twospoons/jayday_fez40/bom_parts.txt

http://www.dipmicro.com/store/index.php?act=viewProd&productCode=CON-MICROSD1
($0.25 per piece)
