twospoons/jayday_fez40/bom.xlsx

Sheet: Sheet1
QTY TOTAL | 100
ADD PERCENT | 1.1 | (10% extra)
QTY | Total Order | Part NO | Price 1 | URL | Value | Device | Package | Description
3 | 330 | 475-1410-1-ND | 0.051 | http://www.digikey.com/product-detail/en/LG%20R971-KN-1-0-20-R18/475-1410-2-ND/1227925 |  | LEDCHIPLED_0805 | CHIPLED_0805 | LED
5 | 550 | 399-1095-1-ND | 0.00808 | http://www.digikey.com/product-detail/en/C0603C104K8RACTU/399-1095-1-ND/411370 | .1uF | C-USC0603K | C0603K | CAPACITOR, American symbol
2 | 220 | 445-1274-1-ND | 0.013 | http://www.digikey.com/product-detail/en/C1608C0G1H270J/445-1274-2-ND/513761 | 27pF | C-USC0603K | C0603K | CAPACITOR, American symbol
2 | 220 | 493-2331-1-ND | 0.22 | http://www.digikey.com/product-detail/en/F921A225MPA/493-2331-1-ND/677799 | 2.2uF | C-USC0805K | C0805K | CAPACITOR, American symbol
1 | 110 | 478-3875-1-ND | 0.32 | http://www.digikey.com/product-detail/en/TAJB106M010RNJ/478-3875-1-ND/1126921 | 10uF | CPOL-USCT3528 | CT3528 | POLARIZED CAPACITOR, American symbol
1 | 110 | 493-4092-1-ND | 0.3 | http://www.digikey.com/product-detail/en/F920J226MPA/493-4092-1-ND/2529819 | 22uF | C-USC0805K | C0805K | CAPACITOR, American symbol
1 | 110 | 399-4781-1-ND | 2.6 | http://www.digikey.com/product-detail/en/T495X227K010ATE060/399-4781-1-ND/1001269 | 220uF 10V B45197A1227K409 | CPOL-USD/7343-31W | D/7343-31W | POLARIZED CAPACITOR, American symbol
1 | 110 | 478-1780-1-ND | 1.71 | http://www.digikey.com/product-detail/en/TPSD156K035R0300/478-1780-1-ND/564812 | 15uF 35V T491D156K035AT | CPOL-USD/7343-31W | D/7343-31W | POLARIZED CAPACITOR, American symbol
1 | 110 | 455-1719-ND | 0.094 | http://www.digikey.com/product-detail/en/S2B-PH-K-S(LF)(SN)/455-1719-ND/926626 |  | JST_2PIN-THM-RA | JST-PH-2-THM-RA | JST 2-Pin Connectors of various flavors
1 | 110 | PRT-09914 | 0.76 | https://www.sparkfun.com/products/9914 | JST FEMALE WITH WIRES
1 | 110 | B260A-FDICT-ND | 0.25 | http://www.digikey.com/product-detail/en/B260A-13-F/B260A-FDICT-ND/755494 | B260 | DIODE_SMA | DIODE_SMA
1 | 110 | 497-11767-ND | 8.84 | http://www.digikey.com/product-detail/en/STM32F405RGT6/497-11767-ND/2754208 | GHI_STM32F40X | GHI_STM32F40X | GHI_LQFP64
1 | 110 | LM1117IMPX-3.3/NOPBCT-ND | 0.768 | http://www.digikey.com/product-detail/en/LM1117IMPX-3.3%2FNOPB/LM1117IMPX-3.3%2FNOPBCT-ND/3440160 | LM1117MP-3.3 | LM1117 | SOT223
1 | 110 | 576-1221-1-ND | 1.97 | http://www.digikey.com/product-detail/en/MIC4680-5.0YM%20TR/576-1221-1-ND/771873 | MIC4680-ADJ | MIC4680 | SO8
1 | 110 | 513-1083-1-ND | 1.22 | http://www.digikey.com/product-detail/en/UP2B-680-R/513-1083-1-ND/695364 | 68uH | UP2BXXX | UP2BXXX
1 | 110 |  | 0.5 |  | SHF105 | SHF105 | GAD_PAC_SMD
2 | 220 |  | 0.1 |  |  | M02PTH | 1X02 | Header 2
3 | 330 | SI2312BDS-T1-GE3CT-ND | 0.28 | http://www.digikey.com/product-detail/en/SI2312BDS-T1-GE3/SI2312BDS-T1-GE3CT-ND/1995606 | SI2312BDS | SI2312BDS | TO-236
1 | 110 | 311-825HRCT-ND | 0.006 | http://www.digikey.com/product-detail/en/RC0603FR-07825RL/311-825HRCT-ND/730352 | 825ohm | R0603
1 | 110 | 887-1268-1-ND | 0.405 | http://www.digikey.com/product-detail/en/9C-12.000MEEJ-T/887-1268-1-ND/2207850 | 12Mhz | CRYTALSM49 | SM49@1 | CRYSTAL
5 | 550 | RNCP0603FTD10K0CT-ND | 0.0086 | http://www.digikey.com/product-detail/en/RNCP0603FTD10K0/RNCP0603FTD10K0CT-ND/2240478 | 10K | R-US_R0603 | R0603 | RESISTOR, American symbol
2 | 220 | 311-22GRCT-ND | 0.004 | http://www.digikey.com/product-detail/en/RC0603JR-0722RL/311-22GRCT-ND/729690 | 22 | R-US_R0603 | R0603 | RESISTOR, American symbol
2 | 220 | 311-330GRCT-ND | 0.0048 | http://www.digikey.com/product-detail/en/RC0603JR-07330RL/311-330GRCT-ND/729716 | 330 | R-US_R0603 | R0603 | RESISTOR, American symbol
3 | 330 | A106046CT-ND | 0.00316 | http://www.digikey.com/product-detail/en/1622827-1/A106046CT-ND/3477684 | 100K | R-US_R0603 | R0603 | RESISTOR, American symbol
1 | 110 | 609-1046-ND | 0.41 | http://www.digikey.com/product-detail/en/54602-908LF/609-1046-ND/1001360 | RJ45-8PTH | RJ45-8PTH | RJ45-8 | RJ45 Jack
1 | 110 |  | 0.24 | http://www.dipmicro.com/store/index.php?act=viewProd&productCode=CON-MICROSD1 | MICROSD_MICROSD | MICROSD_MICROSD | MICROSD_MICROSD
1 | 110 | 649-10033526-N3212LF | 0.4 | http://www.mouser.com/ProductDetail/FCI/10033526-N3212LF/ | DX2R005HN2E700 | USB-MB-S | USB-MB-S | USB Connectors
1 | 110 | PCB | 1
Price per |  |  | 22.48564
Modem |  |  | 29
Stencil |  |  | 45
Price for 100 |  |  | 5708.4204

Sheet: Sheet2
Part | Part NO | Price (when ordering 100x) | URL | Value | Device | Package | Description
+5V | 475-1410-1-ND | 0.059 | http://www.digikey.com/product-detail/en/LG%20R971-KN-1-0-20-R18/475-1410-2-ND/1227925 |  | LEDCHIPLED_0805 | CHIPLED_0805 | LED
+12V | 475-1410-1-ND | 0.059 | http://www.digikey.com/product-detail/en/LG%20R971-KN-1-0-20-R18/475-1410-2-ND/1227925 |  | LEDCHIPLED_0805 | CHIPLED_0805 | LED
C1 |  |  |  | .1uF | C-USC0603K | C0603K | CAPACITOR, American symbol
C2 |  |  |  | .1uF | C-USC0603K | C0603K | CAPACITOR, American symbol
C3 |  |  |  | .1uF | C-USC0603K | C0603K | CAPACITOR, American symbol
C4 |  |  |  | .1uF | C-USC0603K | C0603K | CAPACITOR, American symbol
C6 |  |  |  | 27pF | C-USC0603K | C0603K | CAPACITOR, American symbol
C7 |  |  |  | 27pF | C-USC0603K | C0603K | CAPACITOR, American symbol
C8 |  |  |  | 2.2uF | C-USC0805K | C0805K | CAPACITOR, American symbol
C9 |  |  |  | 2.2uF | C-USC0805K | C0805K | CAPACITOR, American symbol
C10 |  |  |  | 10uF | CPOL-USCT3528 | CT3528 | POLARIZED CAPACITOR, American symbol
C12 |  |  |  | .1uF | C-USC0603K | C0603K | CAPACITOR, American symbol
C13 |  |  |  | 22uF | C-USC0805K | C0805K | CAPACITOR, American symbol
C29 |  |  |  | 220uF 6.3V B45197A1227K409 | CPOL-USD/7343-31W | D/7343-31W | POLARIZED CAPACITOR, American symbol
C37 |  |  |  | 15uF 35V T491D156K035AT | CPOL-USD/7343-31W | D/7343-31W | POLARIZED CAPACITOR, American symbol
CN1 |  |  |  |  | JST_2PIN-THM-RA | JST-PH-2-THM-RA | JST 2-Pin Connectors of various flavors
D7 |  |  |  | B260 | DIODE_SMA | DIODE_SMA
IC1 |  |  |  | GHI_STM32F40X | GHI_STM32F40X | GHI_LQFP64
IC2 |  |  |  | LM1117MP-3.3 | LM1117 | SOT223
IC9 |  |  |  | MIC4680-ADJ | MIC4680 | SO8
L4 |  |  |  | 68uH | UP2BXXX | UP2BXXX
LCD_OUT |  |  |  | SHF105 | SHF105 | GAD_PAC_SMD
LDR |  |  |  |  | M02PTH | 1X02 | Header 2
M_SENS |  |  |  | SI2312BDS | SI2312BDS | TO-236
N_M_HEAT |  |  |  | SI2312BDS | SI2312BDS | TO-236
N_M_LCD |  |  |  | SI2312BDS | SI2312BDS | TO-236
O1 |  |  |  | 12Mhz | CRYTALSM49 | SM49@1 | CRYSTAL
R1 |  |  |  | 10K | R-US_R0603 | R0603 | RESISTOR, American symbol
R2 |  |  |  | 10K | R-US_R0603 | R0603 | RESISTOR, American symbol
R3 |  |  |  | 10K | R-US_R0603 | R0603 | RESISTOR, American symbol
R4 |  |  |  | 22 | R-US_R0603 | R0603 | RESISTOR, American symbol
R5 |  |  |  | 22 | R-US_R0603 | R0603 | RESISTOR, American symbol
R6 |  |  |  | 10K | R-US_R0603 | R0603 | RESISTOR, American symbol
R7 |  |  |  | 330 | R-US_R0603 | R0603 | RESISTOR, American symbol
R8 |  |  |  | 330 | R-US_R0603 | R0603 | RESISTOR, American symbol
R9 |  |  |  | 330 | R-US_R0603 | R0603 | RESISTOR, American symbol
R10 |  |  |  | 100K | R-US_R0603 | R0603 | RESISTOR, American symbol
R11 |  |  |  | 100K | R-US_R0603 | R0603 | RESISTOR, American symbol
R12 |  |  |  | 100K | R-US_R0603 | R0603 | RESISTOR, American symbol
R13 |  |  |  | 10K | R-US_R0603 | R0603 | RESISTOR, American symbol
RST |  |  |  |  | M02PTH | 1X02 | Header 2
SIM900-EXT |  |  |  |  | M081X08 | 1X08 | Header 8
U$2 | 609-1046-ND | 0.41 | http://www.digikey.com/product-detail/en/54602-908LF/609-1046-ND/1001360 | RJ45-8PTH | RJ45-8PTH | RJ45-8 | RJ45 Jack
U3 |  | 0.24 | http://www.dipmicro.com/store/index.php?act=viewProd&productCode=CON-MICROSD1 | MICROSD_MICROSD | MICROSD_MICROSD | MICROSD_MICROSD
VCC | 475-1410-1-ND | 0.059 | http://www.digikey.com/product-detail/en/LG%20R971-KN-1-0-20-R18/475-1410-2-ND/1227925 |  | LEDCHIPLED_0805 | CHIPLED_0805 | LED
X4 | 649-10033526-N3212LF | 0.4 | http://www.mouser.com/ProductDetail/FCI/10033526-N3212LF/ | DX2R005HN2E700 | USB-MB-S | USB-MB-S | USB Connectors

Sheet: Sheet3
sim
http://imall.iteadstudio.com/im120525010.html
$29 for 100
