twospoons/jayday_fez40/jayday_fez40.brd

## EAGLE design jayday_fez40.brd (2012-10-26)

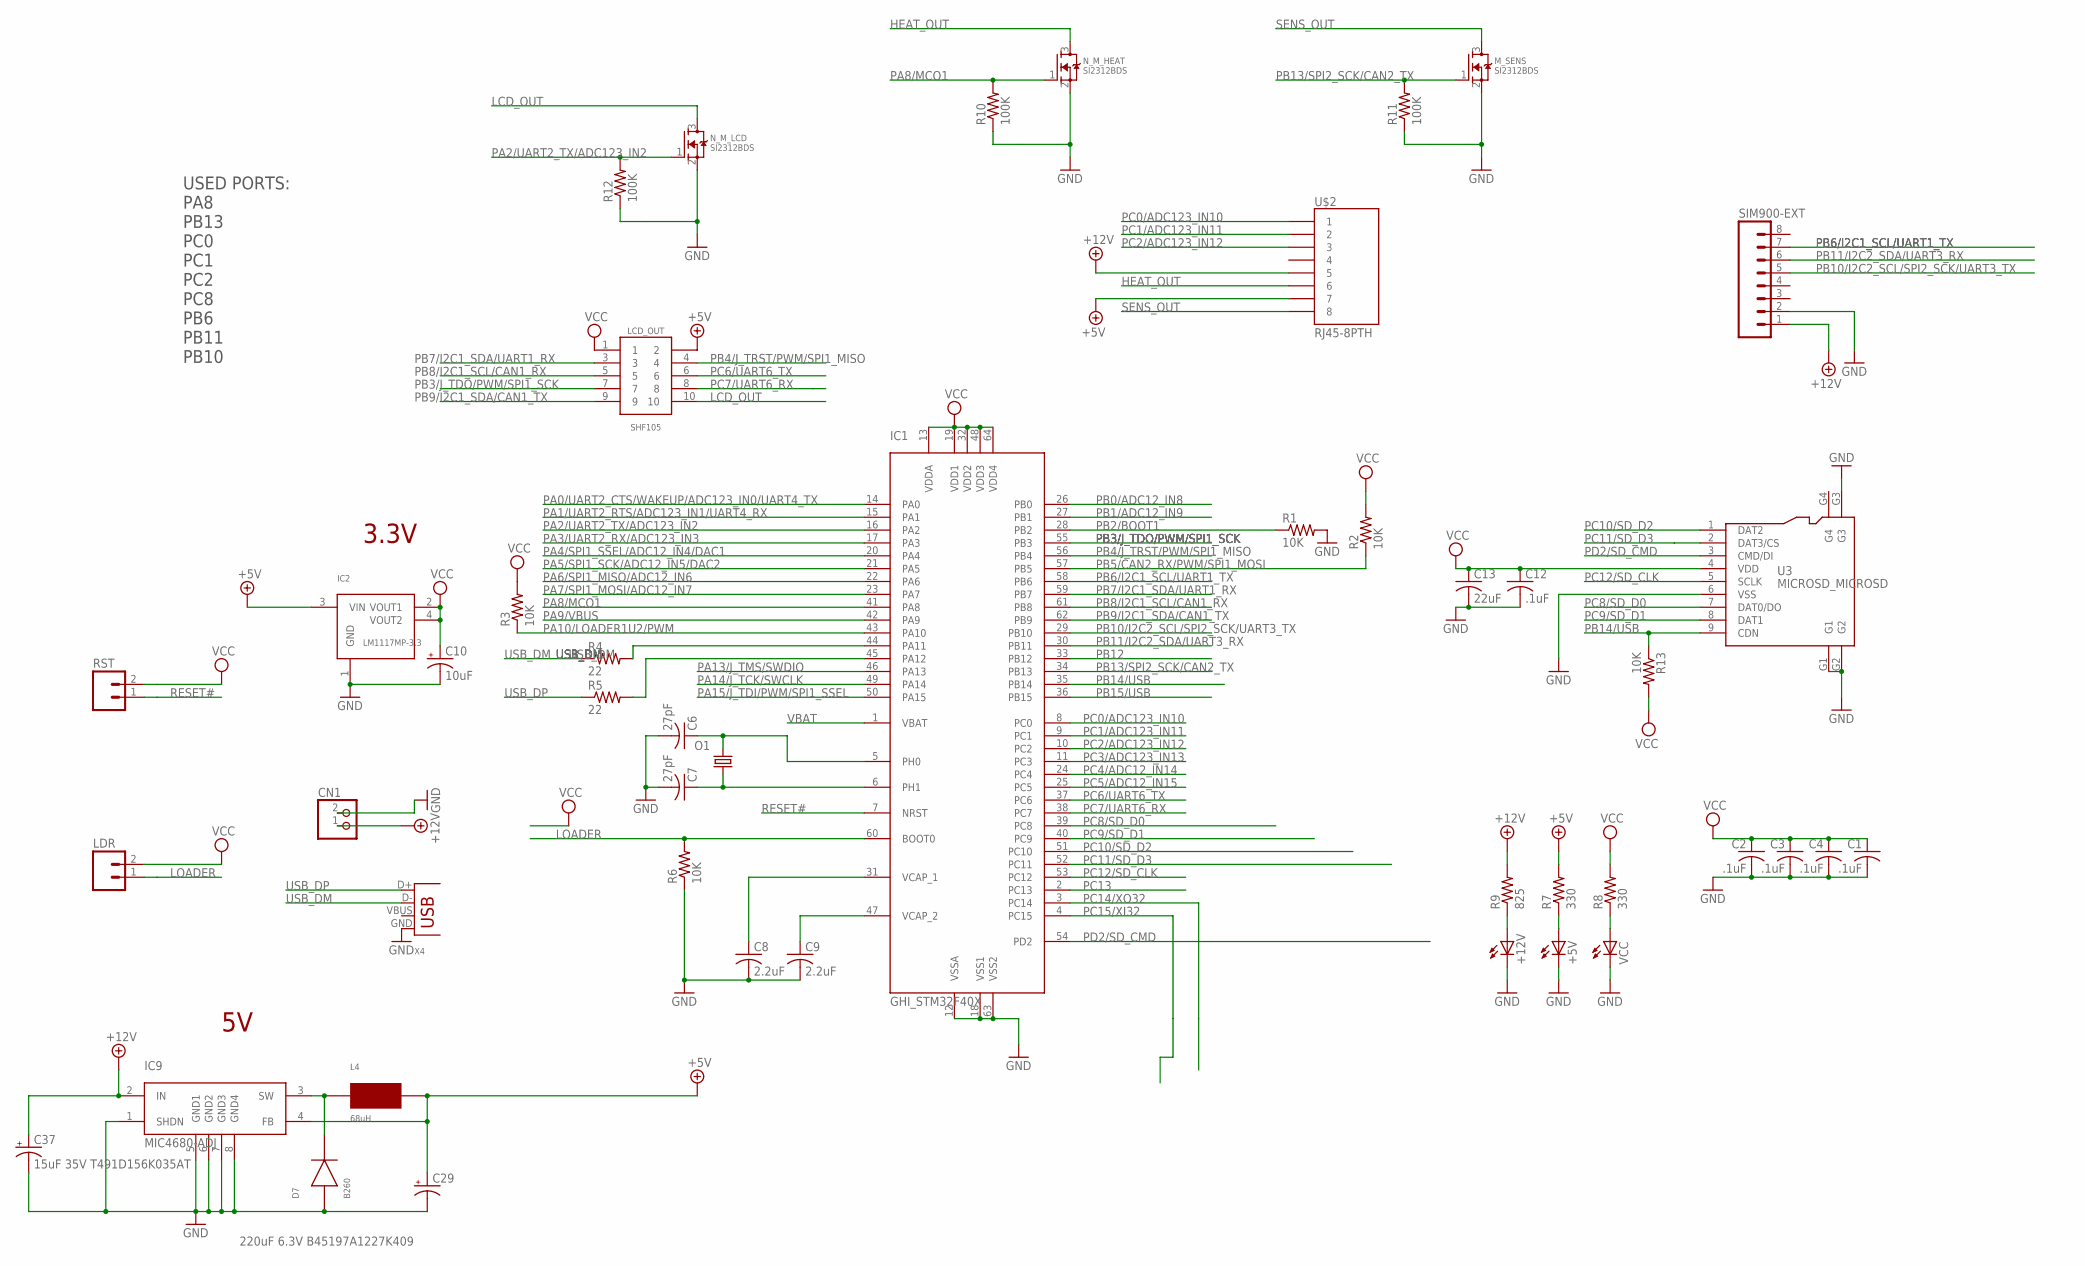
[picture p1: schematic jayday_fez40.sch]

Parts:
+5V, +12V: LEDCHIPLED_0805; CHIPLED_0805
C1, C2, C3, C4, C12: .1uF; C0603K
C6, C7: 27pF; C0603K
C8, C9: 2.2uF; C0805K
C10: 10uF; CT3528
C13: 22uF; C0805K
C29: 220uF 6.3V B45197A1227K409; D/7343-31W
C37: 15uF 35V T491D156K035AT; D/7343-31W
CN1: JST_2PIN-THM-RA; JST-PH-2-THM-RA
D7: B260; DIODE_SMA
IC1: GHI_STM32F40X; GHI_LQFP64
IC2: LM1117MP-3.3; SOT223
IC9: MIC4680-ADJ; SO8
L4: 68uH; UP2BXXX
LCD_OUT: SHF105; GAD_PAC_SMD
LDR: M02PTH; 1X02
M_SENS: SI2312BDS; TO-236
N_M_HEAT: SI2312BDS; TO-236
N_M_LCD: SI2312BDS; TO-236
O1: 12Mhz; SM49@1
R1, R2, R3, R6, R13: 10K; R0603
R4, R5: 22; R0603
R7, R8: 330; R0603
R9: 825; R0603
R10, R11, R12: 100K; R0603
RST: M02PTH; 1X02
SIM900-EXT: M081X08; 1X08
U3: MICROSD_MICROSD
U$2: RJ45-8PTH; RJ45-8
VCC: LEDCHIPLED_0805; CHIPLED_0805
X4: DX2R005HN2E700; USB-MB-S

Connections:
+5V: C29.+, IC2.3 (VIN), IC9.4 (FB), L4.P$2 (2), LCD_OUT.2, R7.2, U$2.7
+12V: C37.+, CN1.1 (2), IC9.2 (IN), R9.2, SIM900-EXT.1, U$2.5
GND: +5V.C, +12V.C, C1.2, C2.2, C3.2, C4.2, C6.2, C7.2, C8.2, C9.2, C10.-, C12.2, C13.2, C29.-, C37.-, CN1.2 (1), D7.A, IC1.12 (VSSA), IC1.18 (VSS1), IC1.63 (VSS2), IC2.1 (GND), IC9.1 (SHDN), IC9.5 (GND1), IC9.6 (GND2), IC9.7 (GND3), IC9.8 (GND4), M_SENS.2 (S), N_M_HEAT.2 (S), N_M_LCD.2 (S), R1.2, R6.1, R10.1, R11.1, R12.1, SIM900-EXT.2, U3.6 (VSS), U3.G1, U3.G2, U3.G3, VCC.C, X4.GND
HEAT_OUT: N_M_HEAT.3 (D), U$2.6
LCD_OUT: LCD_OUT.10, N_M_LCD.3 (D)
LOADER: IC1.60 (BOOT0), LDR.1, R6.2
unnamed: C9.1, IC1.47 (VCAP_2)
unnamed: C8.1, IC1.31 (VCAP_1)
unnamed: IC1.44 (PA11), R4.2
unnamed: IC1.45 (PA12), R5.2
unnamed: D7.K, IC9.3 (SW), L4.P$1 (1)
unnamed: +5V.A, R7.1
unnamed: R8.1, VCC.A
unnamed: +12V.A, R9.1
PA0/UART2_CTS/WAKEUP/ADC123_IN0/UART4_TX: IC1.14 (PA0)
PA1/UART2_RTS/ADC123_IN1/UART4_RX: IC1.15 (PA1)
PA2/UART2_TX/ADC123_IN2: IC1.16 (PA2), N_M_LCD.1 (G), R12.2
PA3/UART2_RX/ADC123_IN3: IC1.17 (PA3)
PA4/SPI1_SSEL/ADC12_IN4/DAC1: IC1.20 (PA4)
PA5/SPI1_SCK/ADC12_IN5/DAC2: IC1.21 (PA5)
PA6/SPI1_MISO/ADC12_IN6: IC1.22 (PA6)
PA7/SPI1_MOSI/ADC12_IN7: IC1.23 (PA7)
PA8/MCO1: IC1.41 (PA8), N_M_HEAT.1 (G), R10.2
PA9/VBUS: IC1.42 (PA9)
PA10/LOADER1U2/PWM: IC1.43 (PA10), R3.1
PA13/J_TMS/SWDIO: IC1.46 (PA13)
PA14/J_TCK/SWCLK: IC1.49 (PA14)
PA15/J_TDI/PWM/SPI1_SSEL: IC1.50 (PA15)
PB0/ADC12_IN8: IC1.26 (PB0)
PB1/ADC12_IN9: IC1.27 (PB1)
PB2/BOOT1: IC1.28 (PB2), R1.1
PB3/J_TDO/PWM/SPI1_SCK: IC1.55 (PB3), LCD_OUT.7
PB4/J_TRST/PWM/SPI1_MISO: IC1.56 (PB4), LCD_OUT.4
PB5/CAN2_RX/PWM/SPI1_MOSI: IC1.57 (PB5), R2.1
PB6/I2C1_SCL/UART1_TX: IC1.58 (PB6), SIM900-EXT.7
PB7/I2C1_SDA/UART1_RX: IC1.59 (PB7), LCD_OUT.3
PB8/I2C1_SCL/CAN1_RX: IC1.61 (PB8), LCD_OUT.5
PB9/I2C1_SDA/CAN1_TX: IC1.62 (PB9), LCD_OUT.9
PB10/I2C2_SCL/SPI2_SCK/UART3_TX: IC1.29 (PB10), SIM900-EXT.5
PB11/I2C2_SDA/UART3_RX: IC1.30 (PB11), SIM900-EXT.6
PB12: IC1.33 (PB12)
PB13/SPI2_SCK/CAN2_TX: IC1.34 (PB13), M_SENS.1 (G), R11.2
PB14/USB: IC1.35 (PB14), R13.1, U3.9 (CDN)
PB15/USB: IC1.36 (PB15)
PC0/ADC123_IN10: IC1.8 (PC0), U$2.1
PC1/ADC123_IN11: IC1.9 (PC1), U$2.2
PC2/ADC123_IN12: IC1.10 (PC2), U$2.3
PC3/ADC123_IN13: IC1.11 (PC3)
PC4/ADC12_IN14: IC1.24 (PC4)
PC5/ADC12_IN15: IC1.25 (PC5)
PC6/UART6_TX: IC1.37 (PC6), LCD_OUT.6
PC7/UART6_RX: IC1.38 (PC7), LCD_OUT.8
PC8/SD_D0: IC1.39 (PC8), U3.7 (DAT0/DO)
PC9/SD_D1: IC1.40 (PC9), U3.8 (DAT1)
PC10/SD_D2: IC1.51 (PC10), U3.1 (DAT2)
PC11/SD_D3: IC1.52 (PC11), U3.2 (DAT3/CS)
PC12/SD_CLK: IC1.53 (PC12), U3.5 (SCLK)
PC13: IC1.2 (PC13)
PC14/XO32: IC1.3 (PC14)
PC15/XI32: IC1.4 (PC15)
PD2/SD_CMD: IC1.54 (PD2), U3.3 (CMD/DI)
RESET#: IC1.7 (NRST), RST.1
SENS_OUT: M_SENS.3 (D), U$2.8
USB_DM: R4.1, X4.D-
USB_DP: R5.1, X4.D+
VBAT: IC1.1 (VBAT)
VCC: C1.1, C2.1, C3.1, C4.1, C10.+, C12.1, C13.1, IC1.13 (VDDA), IC1.19 (VDD1), IC1.32 (VDD2), IC1.48 (VDD3), IC1.64 (VDD4), IC2.2 (VOUT1), IC2.4 (VOUT2), LCD_OUT.1, LDR.2, R2.2, R3.2, R8.2, R13.2, RST.2, U3.4 (VDD)
XTAL3: C6.1, IC1.5 (PH0), O1.2
XTAL4: C7.1, IC1.6 (PH1), O1.1

Notes on the sheet:
3.3V
USED PORTS: PA8 PB13 PC0 PC1 PC2 PC8 PB6 PB11 PB10

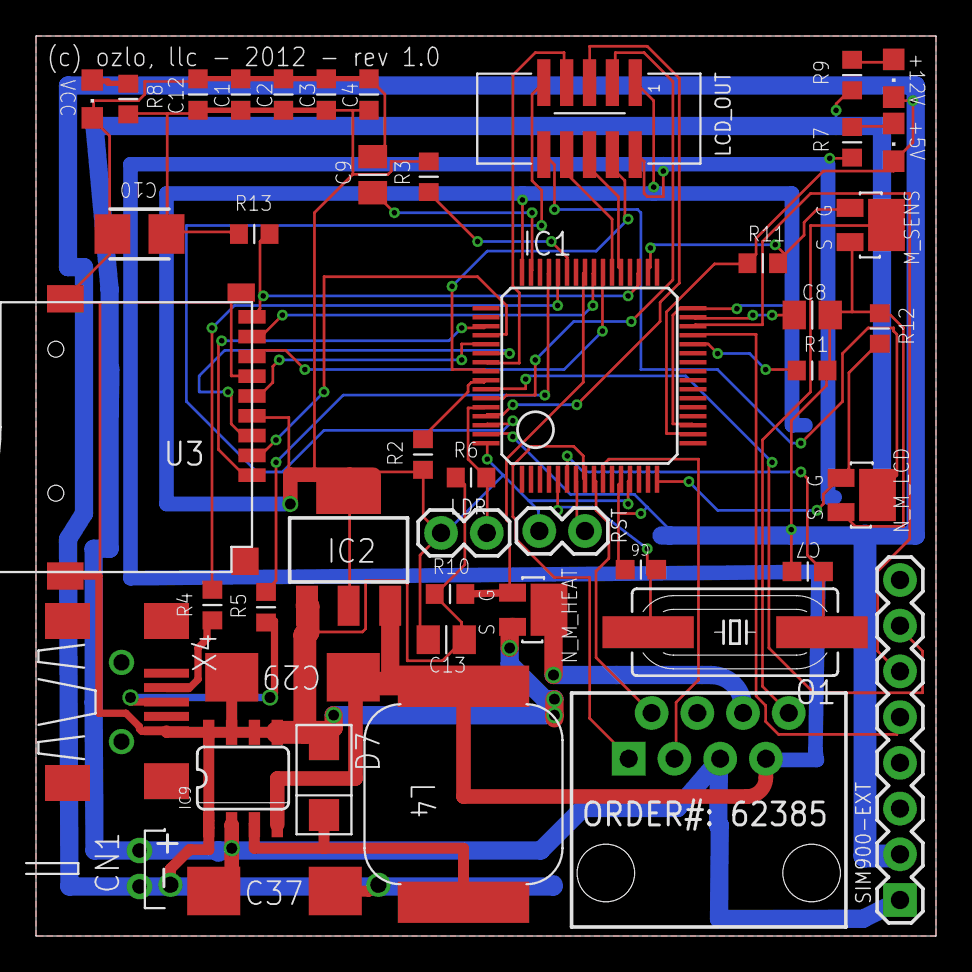
[picture p2: board jayday_fez40.brd from above]

Board: 2 copper layers, 50.0 x 50.0 mm, 46 parts (0 on the bottom side), 47 nets.
