twospoons/jayday_fez40/(commit log)

2012-10-23 custom stmf impl
    [FEZ Cerb40.brd, FEZ Cerb40.sch, jayday_fez40.brd, jayday_fez40.sch]
2012-10-24 layed out board.. 2 traces left
    [jayday_fez40.brd, jayday_fez40.sch]
2012-10-25 finished layout
    [jayday_fez40.brd, jayday_fez40.sch]
2012-10-26 added bom, and shipped pcb
    [bom.xlsx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]
2012-10-26 fixed R9 to 825ohms
    [bom.xlsx, jayday_fez40.brd, jayday_fez40.sch]
2012-11-04 Added bom
    [bom.xlsx]
